stockton-stem/stockton-stem-badge/(commit log)

2017-05-18 Skeleton Kicad schematic/parts/board
    [stockton-stem-badge.kicad_pcb, stockton-stem-badge.sch]
2017-05-19 First pass at the schematic
    - PIC and 4 LEDs, with a first approximation at footprints
    [stockton-stem-badge.kicad_pcb, stockton-stem-badge.sch]
2017-05-19 Experiment with STEM logo on the silkscreen
    - Still far from a usable layout, experiment with getting the
    Stockton STEM logo onto the board
    - Note that the PCB library path seems to be fully-qualified;
    need to see if that can be made relative
    [stockton-stem-badge.kicad_pcb, stockton-stem-badge.sch]
2017-05-19 Basic routing
    - Route the nets
    - Add ICSP header
    - Add 3D model of IC to U1
    Board is too big, but it's a first approximation.
    [stockton-stem-badge.kicad_pcb, stockton-stem-badge.sch]
2017-05-20 Flesh out program build structure
    - Add basic peripheral initialization, including PWM and timer
    - Add config.h with chip config
    - Add badge.[ch] with very crude loop to test the PWMs
2017-05-21 Remove defunct PIC12F1571 elements
    - Remove 12F1571 datasheets and parts
    - Document the 12LF1501 part
    - Use 12LF1501 in the schematic
    [stockton-stem-badge.sch]
2017-05-21 Add schematic export file to ignore list
2017-05-22 Made the board smaller
    - Reduced the graph to just the lines; used a text object for the rest
    - Moved the battery holder to the back; though we will
    probably need to swap it for a more basic one (for cost)
    - Shrunk the overall board size and rearranged stuff accordingly; may need to go smaller still however
    [stockton-stem-badge.kicad_pcb, stockton-stem-badge.sch]
2017-05-22 Tweak the silkscreen
    - Move various component values into the silkscreen layer
    - Label the LEDs by color
    [stockton-stem-badge.sch]
2017-05-23 Update README with progress
    - Pictures of progress
    [stockton-stem-badge.kicad_pcb, stockton-stem-badge.sch]
2017-05-25 Add new CR2032 footprint for the BAT-HLD-001-THM partt
    [stockton-stem-badge.kicad_pcb, stockton-stem-badge.sch]
2017-05-25 Start adding BOM data to the schematic
    - Also tidy up part lib path for images
    [stockton-stem-badge.kicad_pcb, stockton-stem-badge.sch]
2017-05-26 Board revision 0.1
    - Fix solder mask layer for battery footprint
    - Board and schematic revision set to 0.1
    - Place two holes on board for badge mounting options
    - Place revision number on board (later see if this can be automagic)
    - Add OSH Park board renders; update README
    - Order boards from OSH Park
    [stockton-stem-badge.kicad_pcb, stockton-stem-badge.sch]
2017-05-26 Fix board image filename
2017-05-26 Add 3d models for color LEDs
    - Small script to take the red 5mm LED and produce the colors we're using; Blue, Green, Yellow, Orange
    - Update layout and render image with color LEDs
    [stockton-stem-badge.kicad_pcb]
2017-05-26 Update PCB layout image
    [stockton-stem-badge.kicad_pcb]
2017-05-26 Add OSHW logo
    - Bump board version to 0.2
    - Change 3d render board color to match OSHPark, for now
    [stockton-stem-badge.kicad_pcb, stockton-stem-badge.sch]
2017-05-26 Move LEDs flush to PCB in 3d render
    [stockton-stem-badge.kicad_pcb]
2017-05-26 Update board layout image
2017-05-26 Fix PWM timing comments
    [config.h, main.c]
2017-05-26 Experiment with PWM values
2017-06-01 Add battery holder datasheet
2017-06-01 Add bulk C, button; adjust power track width
    - Add a bulk storage cap, value TBD but hopefulyl 47uF
    - Add a button
    - Increase track width for VDD and GND
    - Add sample LED current resistor values
    - Add VPP 10K pullup
    [stockton-stem-badge.kicad_pcb, stockton-stem-badge.sch]
2017-06-01 Don't track certain generated MPLAB project files
2017-06-01 Update board images
2017-06-02 Save the v0.2 gerber files
    [stockton-stem-badge-B.Cu.gbl, stockton-stem-badge-B.Mask.gbs, stockton-stem-badge-B.SilkS.gbo, stockton-stem-badge-Edge.Cuts.gm1, stockton-stem-badge-F.Cu.gtl, stockton-stem-badge-F.Mask.gts, stockton-stem-badge-F.SilkS.gto, stockton-stem-badge.drl]
2017-06-02 Bump board version to 0.3
    [stockton-stem-badge.kicad_pcb, stockton-stem-badge.sch]
2017-06-02 Skeleton of the interrupt handler and config
2017-06-03 More work on the timer-sleep logic
    - Setup timer1
    - Add a go_to_sleep routine that turns of any LED first
    - Some small optimizations:
    - Use known-size types
    - Reorder some setup operations to make use of '0' already being in a register
2017-06-03 Working sleep after n-secs of runtime + wakeup on input
    - Timer1 setup for 0.5Hz
    - SLEEP after n-iterations of timer1
    - wakeup on interrupt (button on RA1)
    - change LED pattern to a ramp up/down sequence
2017-06-04 Add pattern selection with tbe button
    - Button triggers timer0; when it overflows the action is triggered.
    This is a simple de-bounce mechanism; the timer runs
    for ~4ms; any noisy button triggers in that interval will
    reset the timer. Thus it waits for the noise to settle.
    - Pattern incremented on button action
    - Button iterate function dispatches to the implementation for each pattern
    [badge.c, badge.h, config.h, main.c]
2017-06-11 Make PICkit 3 profile not power device
2017-06-12 Update LED values for latest iteration of the board
    - Correct PWM max duty cycle value
    - Blue no longer needs to be /2
    [badge.c]
2017-06-12 Correct range for basic_ramp pattern
    - Was limiting to mv/2, for now simply <<1 it
    [badge.c]
2017-06-13 Increase button debounce delay
    - Increase timer prescaler to 1:256, increasing the timer period from ~4ms to ~16ms. This should quell more button bounciness.
    - Fix various typos in the README
    [config.h]
2017-06-17 Update part values & metadata
    - Update R value
    - Add more BOM data
    - Add datasheets for most parts
    [stockton-stem-badge.sch]
2017-06-18 Updates to BOM
    BOM updates:
    - change mrf part field tro pard# for kicost script
    - update LED part numbers & datasheets
    - yellow was a low-stock part
    - yellow&green were on tape
    - update resistor for orange to same as for green/yellow
    for simplicity and should work just fine
    Minor board updates:
    - Import new netlist values
    - add kicost output files to .gitignore
    [stockton-stem-badge.kicad_pcb, stockton-stem-badge.sch]
2017-07-02 Add 0ohm link
    - Add a net for the 0ohm resistor; it can be cut on the board if needed but saves one componment.
    - Update some part links
    [stockton-stem-badge.sch]
2017-07-02 Move battery
    - Move the battery closer the edge
    - Import latest net, add 0ohm link
    [stockton-stem-badge.kicad_pcb]
2017-07-02 Generate board gerbers/images
    [stockton-stem-badge-B.Cu.gbl, stockton-stem-badge-B.Mask.gbs, stockton-stem-badge-B.SilkS.gbo, stockton-stem-badge-Edge.Cuts.gm1, stockton-stem-badge-F.Cu.gtl, stockton-stem-badge-F.Mask.gts, stockton-stem-badge-F.SilkS.gto, stockton-stem-badge.drl]
2017-07-02 Bump version to 0.4
    - also include v0.3 renders in readme
    [stockton-stem-badge.kicad_pcb, stockton-stem-badge.sch]
2017-07-03 Change pattern dispatch to fn table
    - Drop the enum & switch and use a function pointer table to dispatch the LED pattern iterator
2017-07-03 Correct the PWRTE config comment
    [pic_config.h]
2017-07-03 Add power commentary to README
    - Add a section discussing power.
    - More detail on the button.
    - Update pattern dispatch section.
2017-07-03 Change pic_config.h to pic_config.c
    - Mere presence of the #pragma config entries are enough, doesn't need to be #included
    [config.h, main.c, pic_config.c]
2017-07-03 ICD3 shouldn't supply power
    - When we have a battery in the device, ICD3 gets confused it is also
    provides power
2017-12-15 Add DNP and missing BoM parts
    - The ICSP header, R1 and R5 are optional, mark them Do Not Populate so they are skipped in the BoM
    - Add non-layout parts to the schematic (DIP IC socket and CR2023 battery) so they appear in the BoM
    - Whilst these have no actual impact on the PCB layout, update the PCB and Gerbers
    [stockton-stem-badge-B.Cu.gbl, stockton-stem-badge-B.Mask.gbs, stockton-stem-badge-B.SilkS.gbo, stockton-stem-badge-Edge.Cuts.gm1, stockton-stem-badge-F.Cu.gtl, stockton-stem-badge-F.Mask.gts, stockton-stem-badge-F.SilkS.gto, stockton-stem-badge.drl]
2017-12-16 Add ICD 3 "powered" target
2017-12-19 Add battery 3d model; fix some other objects
    - Scale and rotation on the header and caps was no longer needed
    [stockton-stem-badge.kicad_pcb]
2017-12-19 Minior tweaks to the BoM only parts
    [stockton-stem-badge.sch]
2017-12-20 Add Stockton logo to the board
    [stockton-stem-badge.kicad_pcb, stockton-stem-badge.sch]
2018-03-04 Add reverse ramp pattern
    [badge.c]
2018-03-04 Make patterns configurable
    - Add #define's for each LED pattern, such that they can be
    individually enabled/disabled
    - Clean up some macro naming and comments
2018-03-10 Bump files to v0.5
    - Remove older images
    - Add v0.4 board renders
    - Update versions ready for v0.5
    [stockton-stem-badge.kicad_pcb, stockton-stem-badge.sch]
