stockton-stem/stockton-stem-badge/(notices)

Notices in the files:
board/stockton-stem-badge.kicad_pcb:
MIT License; (c) 2017 Chris Luke
